chenjiatian/light-control/(list of files, cad)

Other CAD files:
light control/light control.OBJ
