chenjiatian/light-control/(commit log)

2017-09-11 添加了代码
    添加了代码
    [light control.OBJ]
2017-09-11 Course Report
    The report contains the introduction of the entire project,and the design principles and ideas of the part of hardware circuit.And the test of the project
